aljabid/traffic-twin-fdi-detection/docs/figures/fig1_system.png

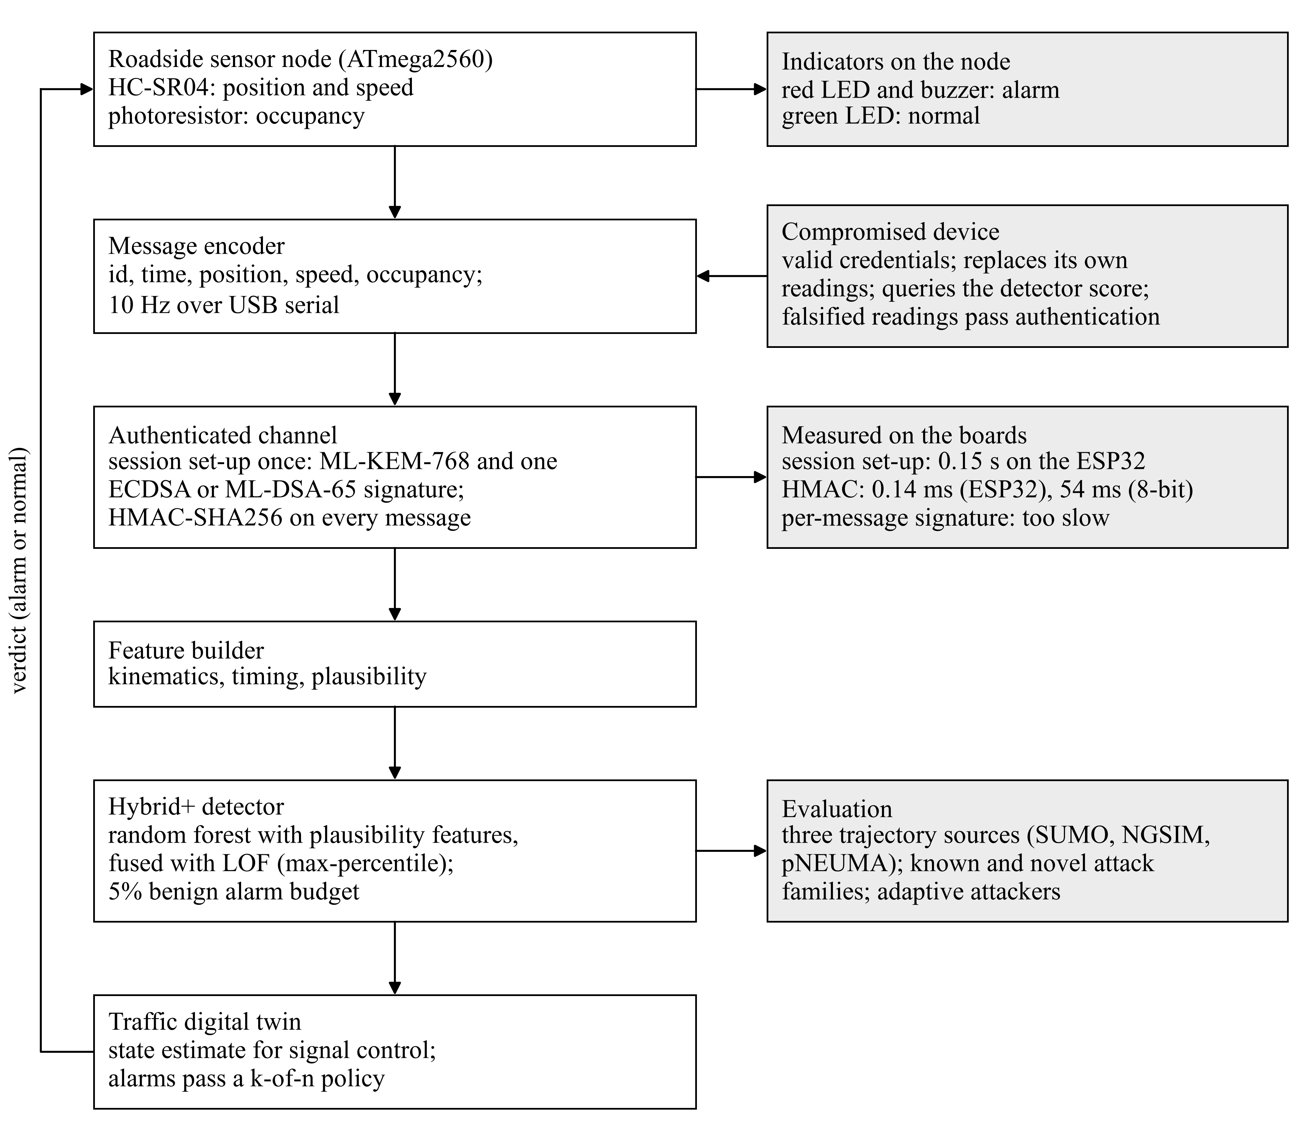
docs/figures/fig1_system.png
