aljabid/traffic-twin-fdi-detection/docs/figures/fig5_detectors.png

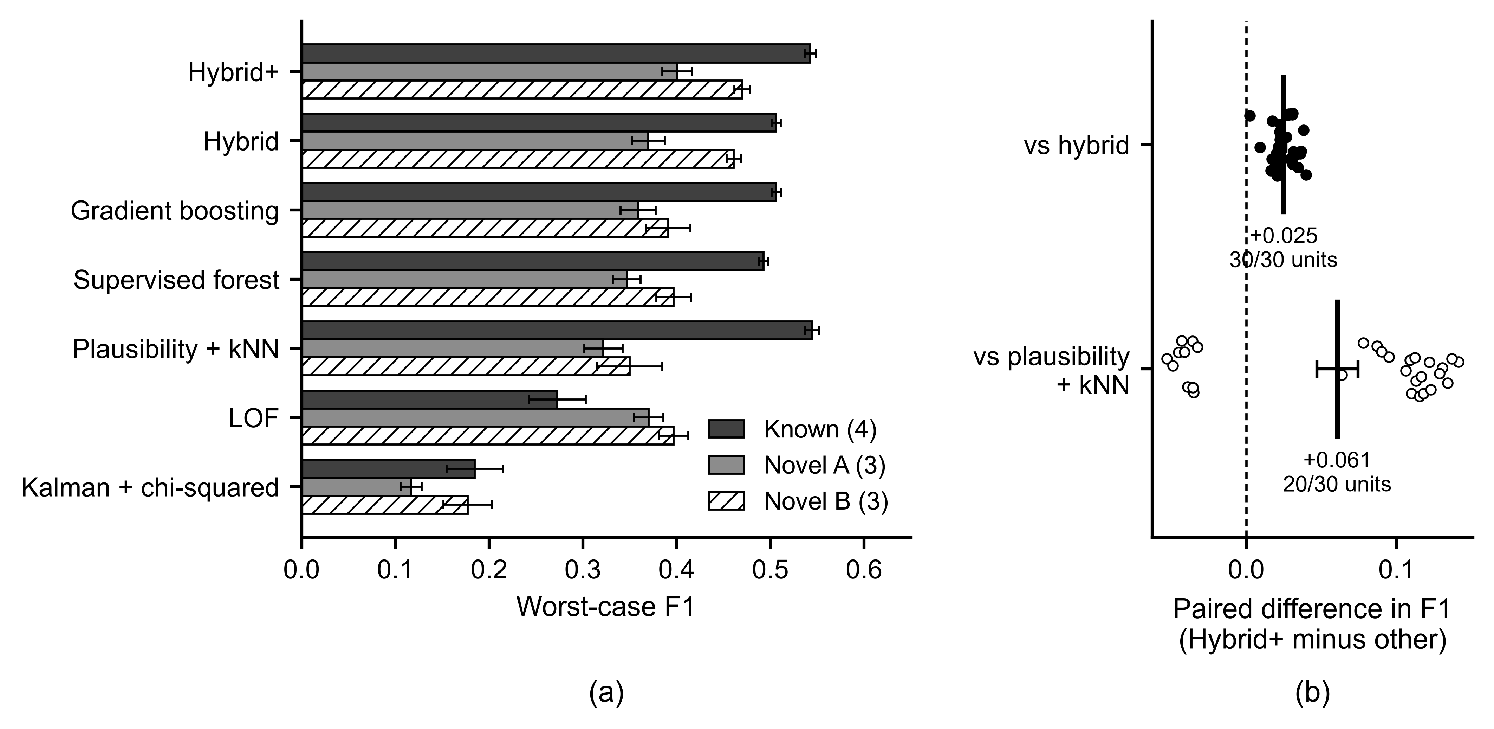
docs/figures/fig5_detectors.png
