aljabid/traffic-twin-fdi-detection/docs/figures/fig6_alarm_tradeoff.png

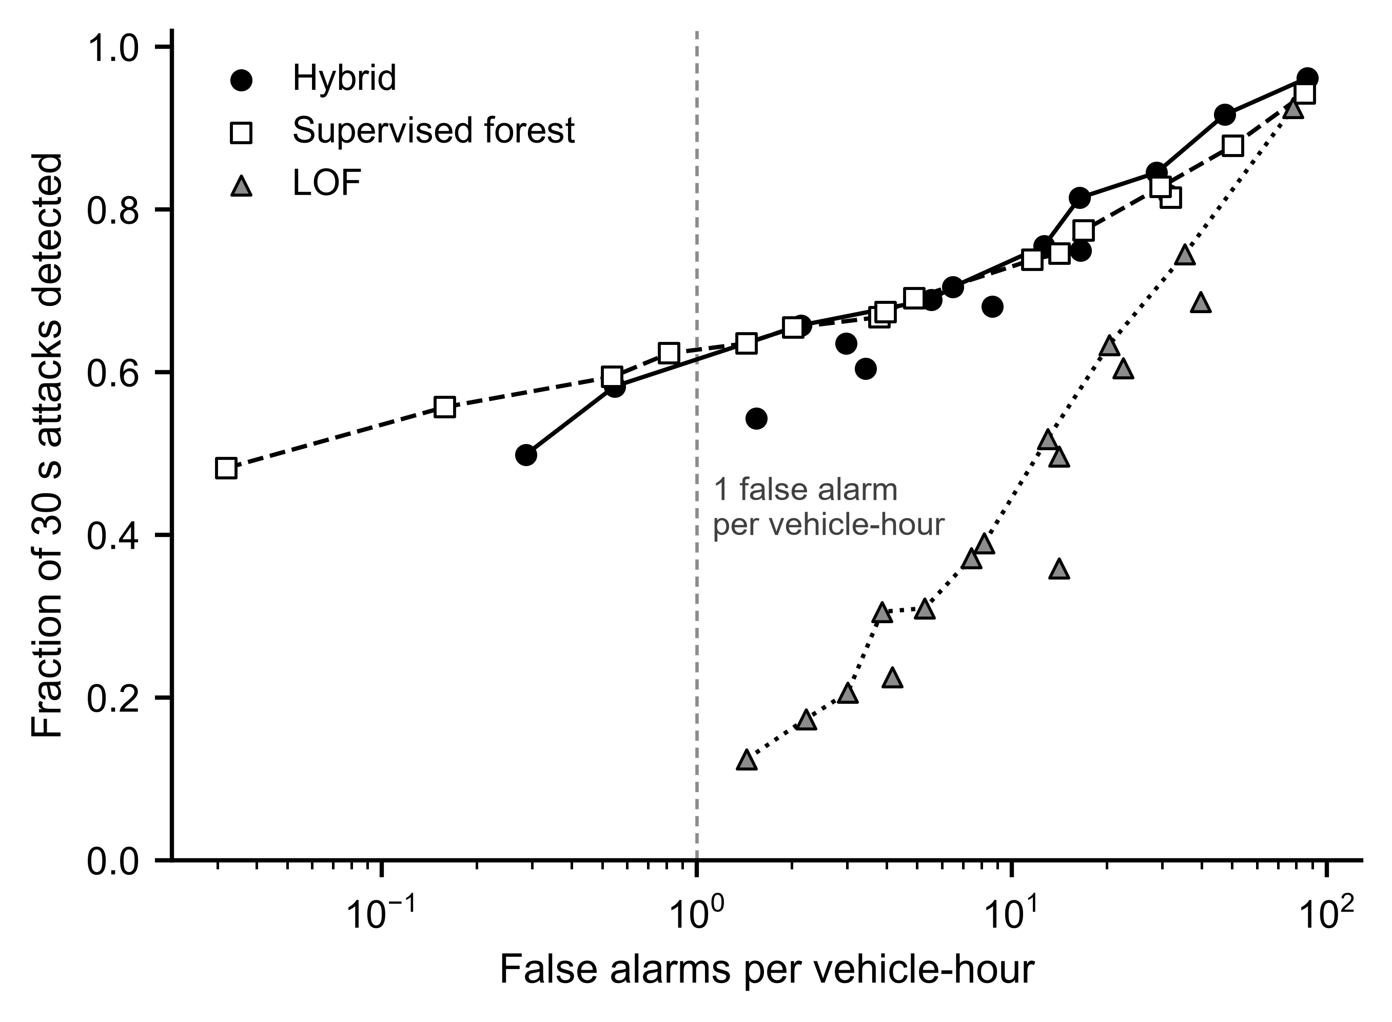
docs/figures/fig6_alarm_tradeoff.png
