aljabid/traffic-twin-fdi-detection/docs/figures/fig7_pitfalls.png

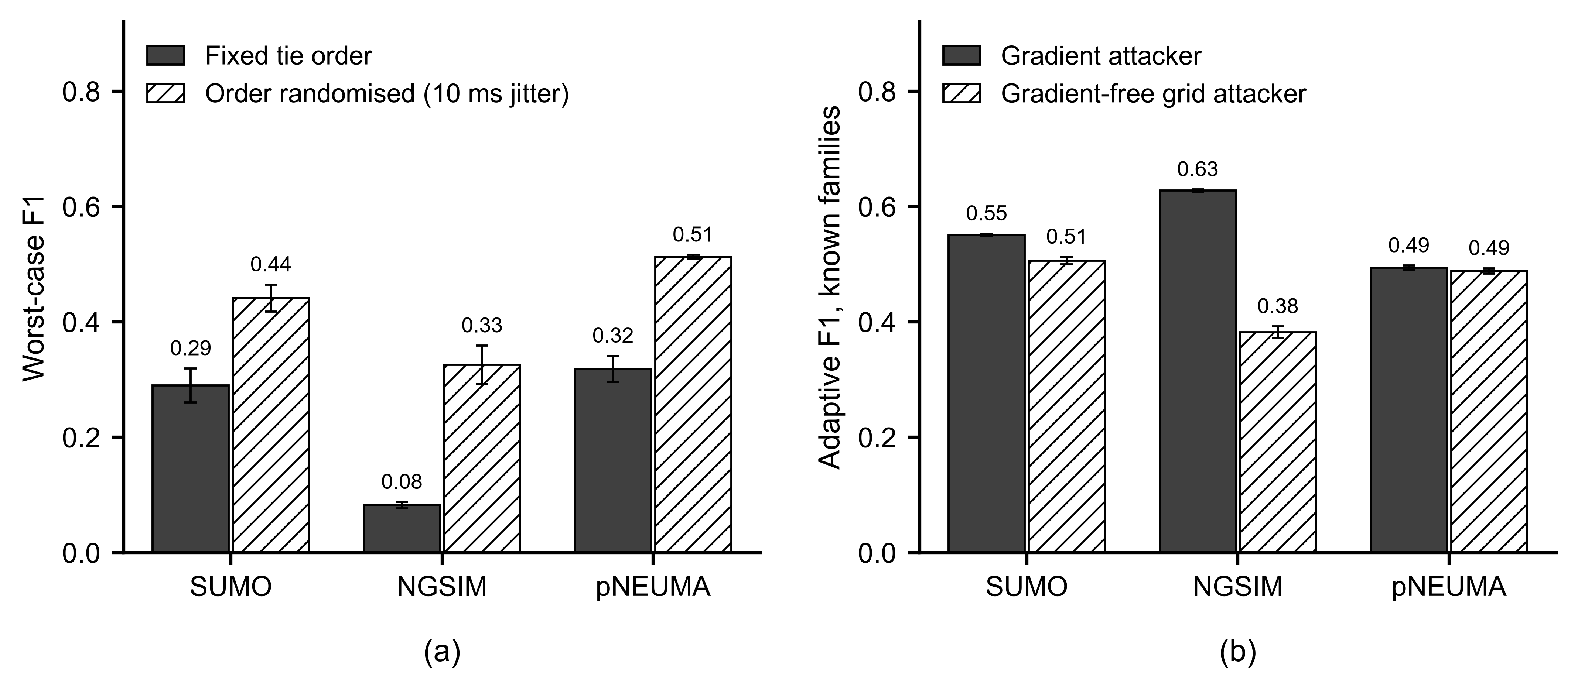
docs/figures/fig7_pitfalls.png
