aljabid/traffic-twin-fdi-detection/docs/figures/fig_live_run.png

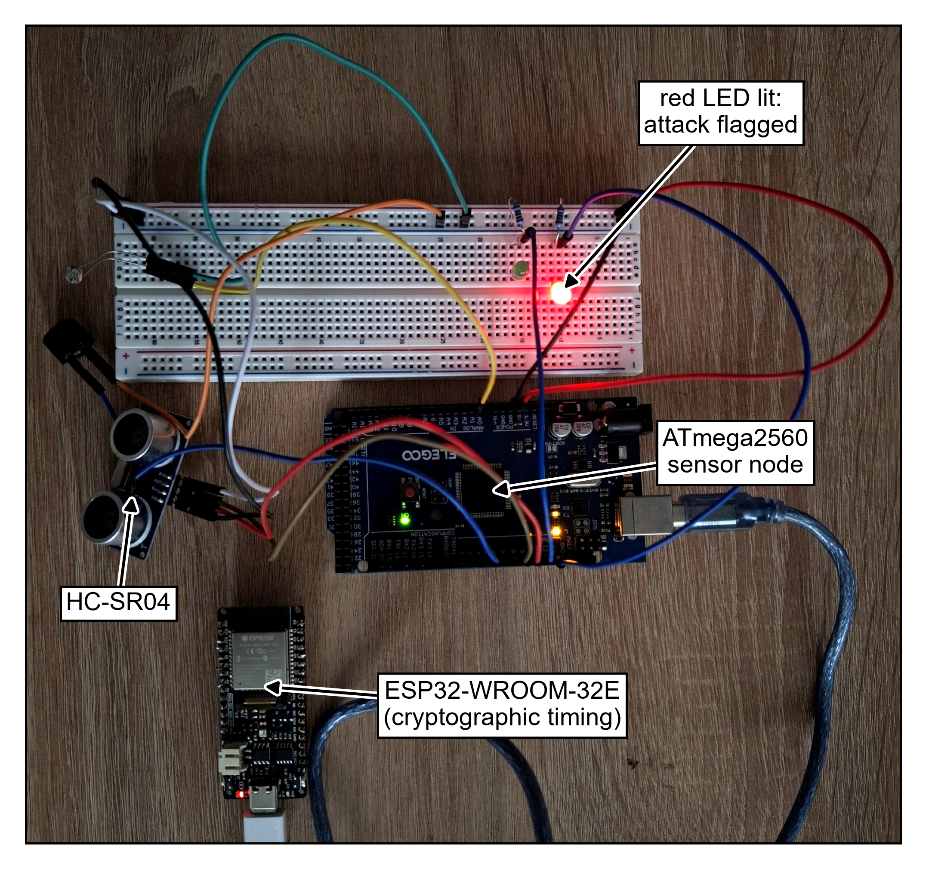
docs/figures/fig_live_run.png
