aljabid/traffic-twin-fdi-detection/docs/figures/photos/bench_attack_esp32.jpg

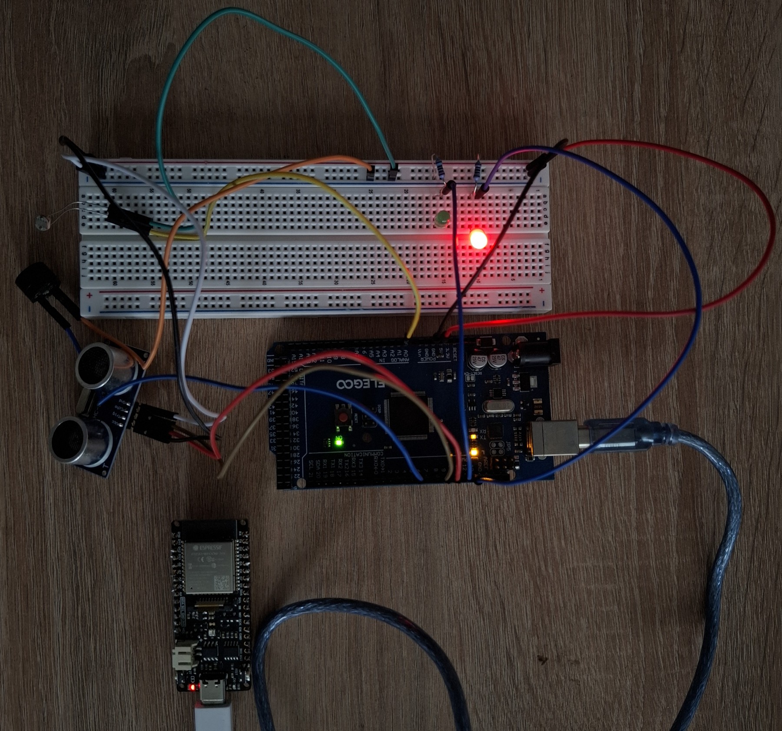
docs/figures/photos/bench_attack_esp32.jpg
