aljabid/traffic-twin-fdi-detection/docs/figures/photos/bench_daylight.jpg

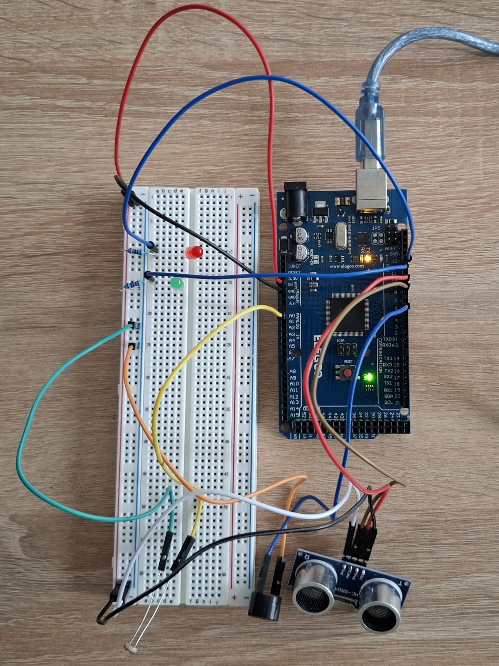
docs/figures/photos/bench_daylight.jpg
