aljabid/traffic-twin-fdi-detection/docs/figures/fig_wiring.png

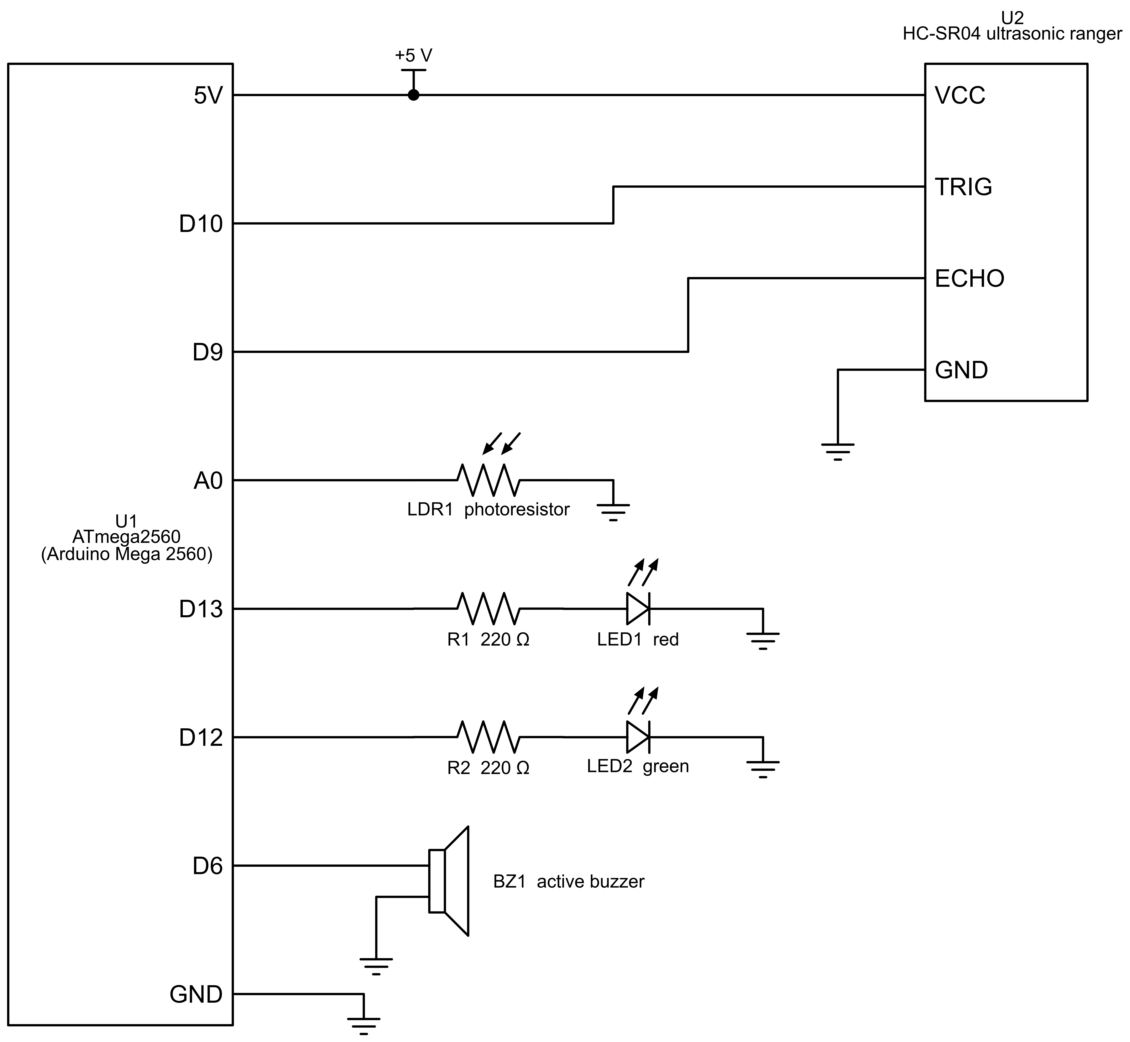
docs/figures/fig_wiring.png
