aljabid/traffic-twin-fdi-detection/(commit log)

2026-10-22 added sensor node firmware
2026-10-22 added esp32 crypto benchmark
2026-10-22 added the flow chart
2026-10-22 added the schematic
